BreastPumpVent/Documentation/README.md

# ArduinoController
Arduino controller code for the breast pump ventilator project.
