BreastPumpVent/Documentation/Important Documents/Ventilator_Schematic_Beast.PNG

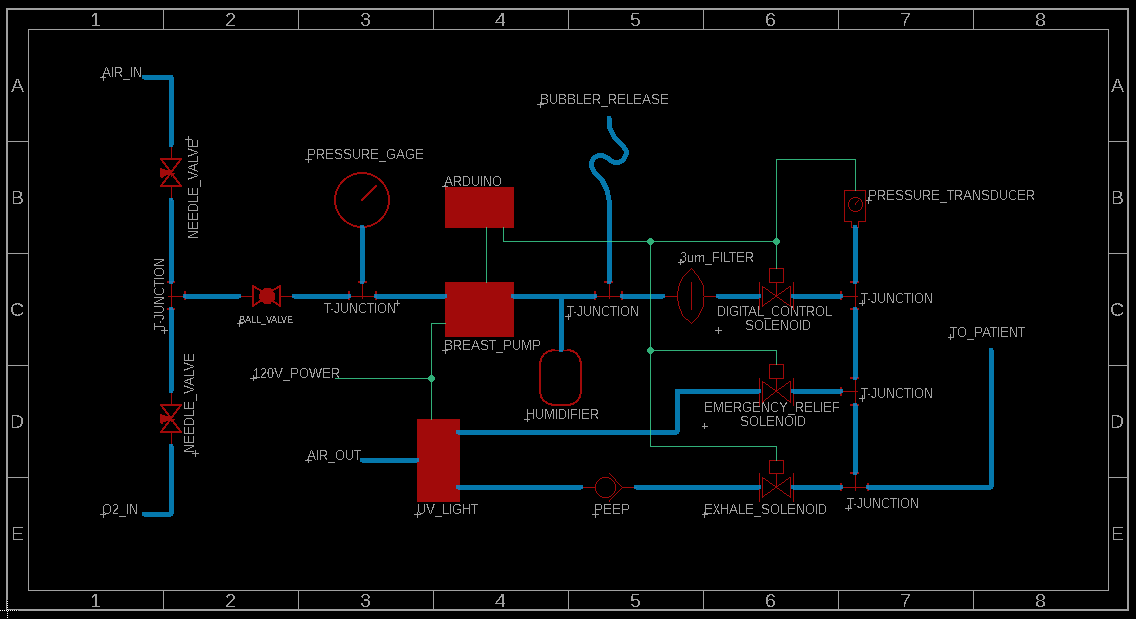
Important Documents/Ventilator_Schematic_Beast.PNG
