BreastPumpVent/Documentation/Important Documents/Breast Pump Ventilator Drawing.pdf

## Breast Pump Ventilator Hardware Design

Design: 28 March 2020 | Drawing: 31 March 2020

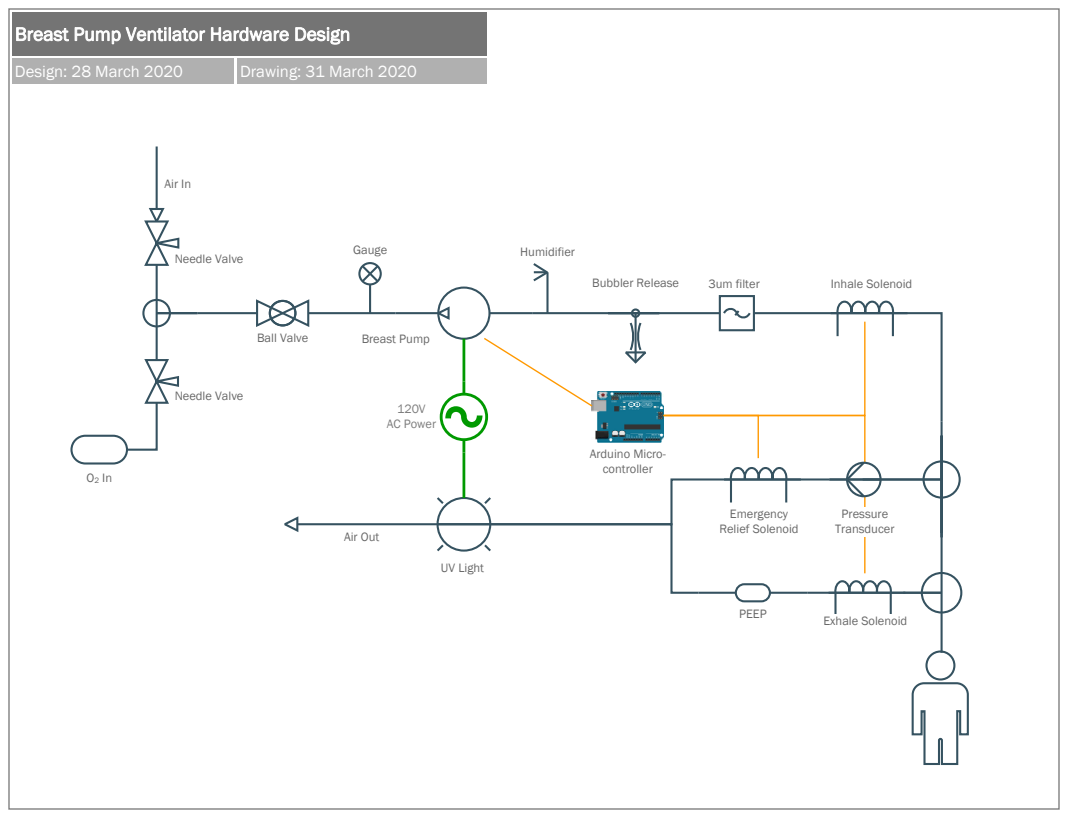
[picture p18: page 1]
Breast Pump; Needle Valve; Ball Valve; Gauge; 3um filter; Inhale Solenoid; Exhale Solenoid; 120V AC Power; Air Out; Bubbler Release; Humidifier; Arduino Micro- controller; Emergency Relief Solenoid; PEEP; Pressure Transducer; UV Light; Air In
