BreastPumpVent/Documentation/Important Documents/Ventilator Circuit Diagram.pdf

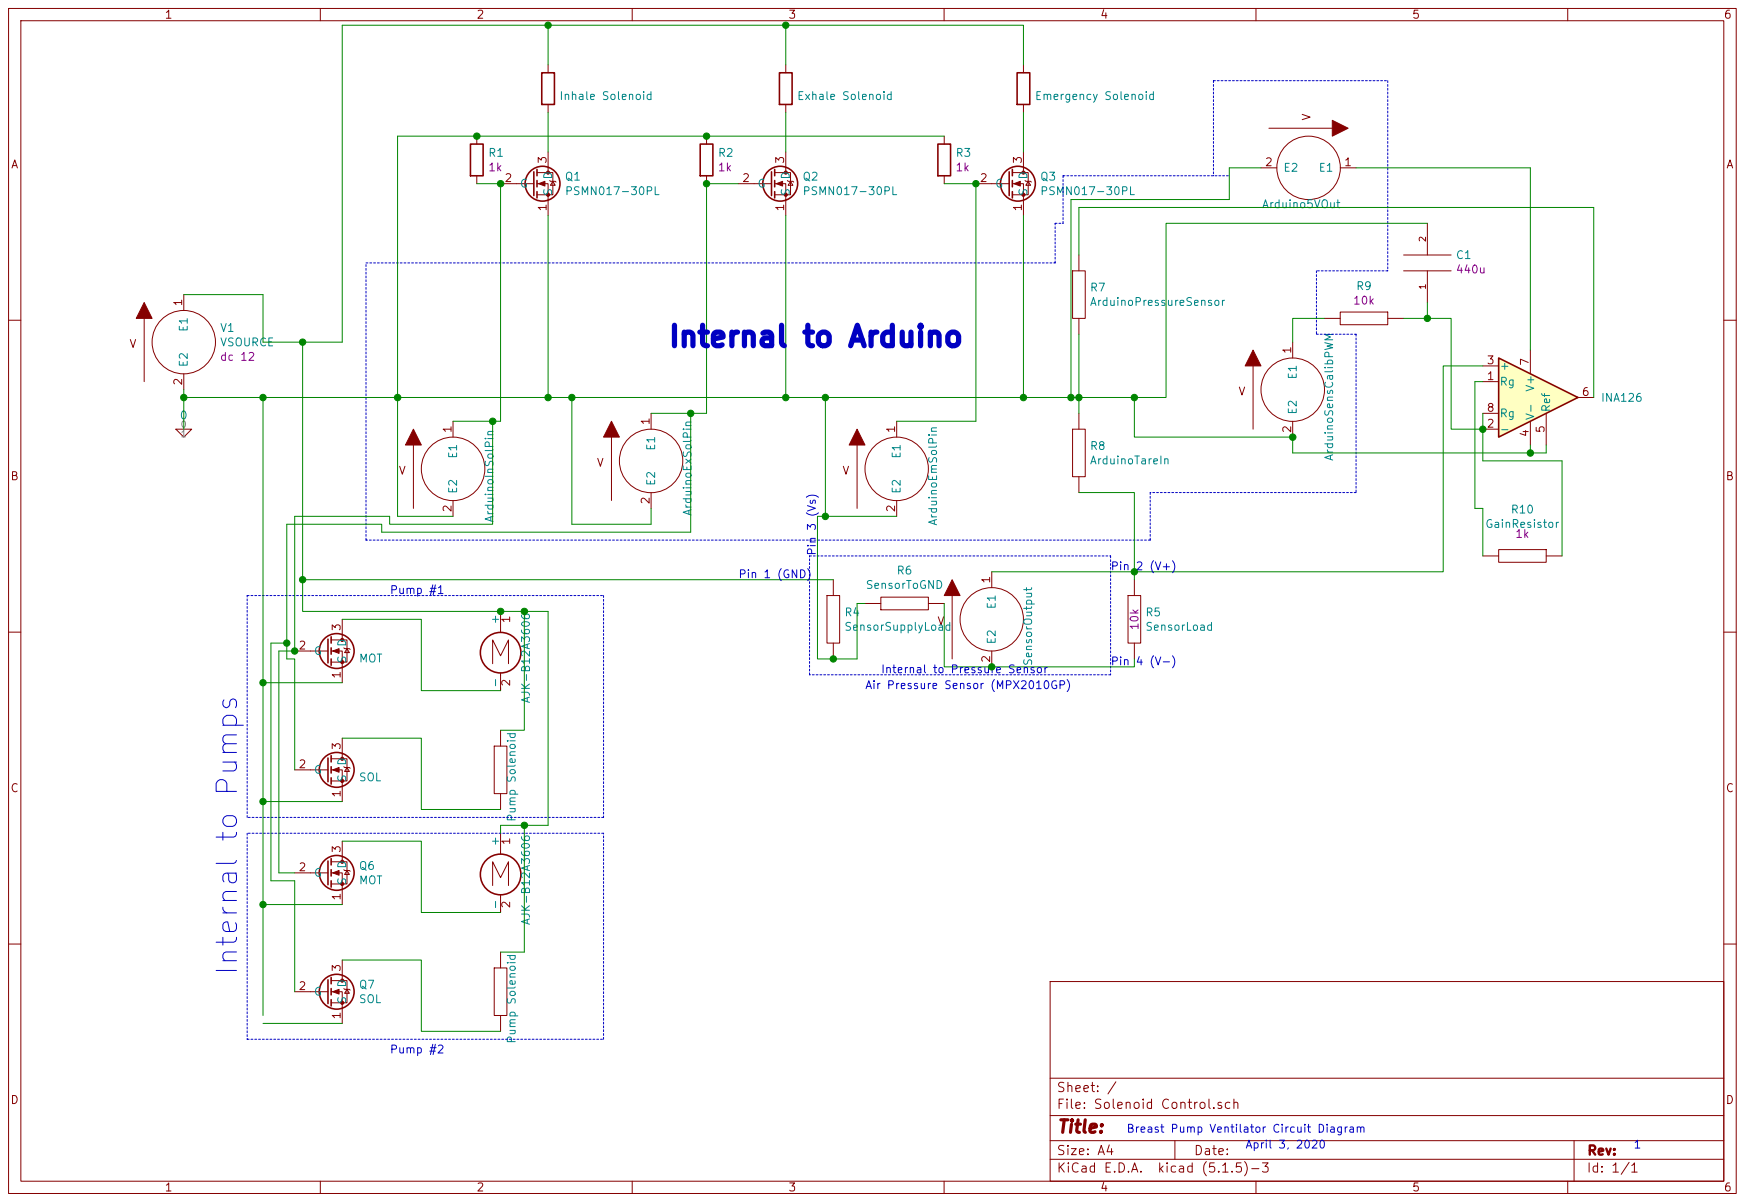
[picture p19: page 1]
