BreastPumpVent/Documentation/(commit log)

2020-04-03 Initial Commit
    Start of the project with the first version of our Arduino Code.
2020-04-03 Informational Documents
    circuit diagram and requirements docs
